openremote/or-dartboard/README.md

# OpenRemote Dartboard

As a proof of concept for connecting a custom-made IoT device to OpenRemote, we developed hardware & software to connect a modified electronic dartboard to OpenRemote, which can then be used to play remote dart games using OpenRemote as an intermediate datastore.

## Documentation

- [Hardware documentation](./docs/hardware.md)
- [Software documentation](./docs/software.md)

## Code

- [ESP32 Code](./esp32)
- [Game logic](./gamelogic)
- [OpenRemote patched w/ custom BLE Support](https://github.com/Raqbit/openremote)
