openremote/or-dartboard/docs/esp32.md

# ESP32 Code

## Diagrams

>**Note**
>
> The diagrams shown here, are made using the [C4 model](https://c4model.com/).
> 
> Also, the code diagrams will not be shown. We will provide you directly with the code.

### (C1) Context Diagram
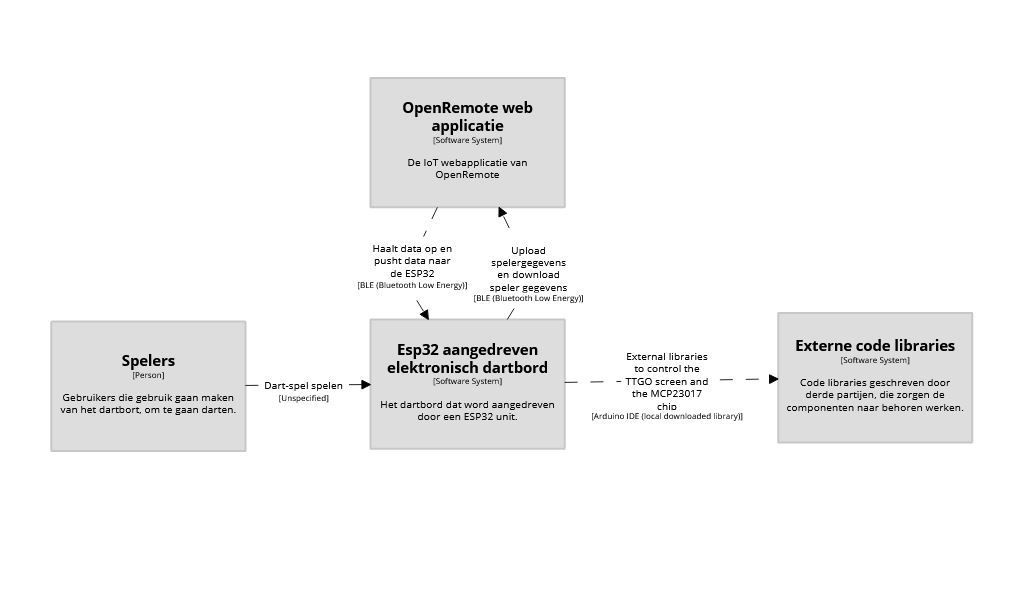
[picture p3: docs/img/esp32/c4/context.jpg]
Context diagram for the ESP32 driven dartboard

>**Note**
>
>These diagrams are written in Dutch. I will do my best to translate them to English correctly.

#### Context overview
In the middle we see our "ESP32 drive electronical dartboard". To the left of the "ESP32 drive electronical dartboard" we see "Players". To the right, wee see "External code libraries." To the top, we see "OpenRemote web application".

* Players interact with the dartboard, throwing darts. No technologies are used for this.
* The ESP32 driven dartboard, will use external code libraries, to make use of the TTGO-T-Display(mounted on the ESP32), the MCP23017 I/O Extender and the Bluetooth Antenne (mounted on the ESP32).
* The Esp32 driven dartboard will also send hit-scan data of darts thrown to OpenRemote. (Using Bluetooth Low Energy)
* OpenRemote will also send data to the ESP32 driven dartboard when needed. (Using Bluetooth Low Energy)

### (C2) Container Diagram Esp32 Driven Dartboard
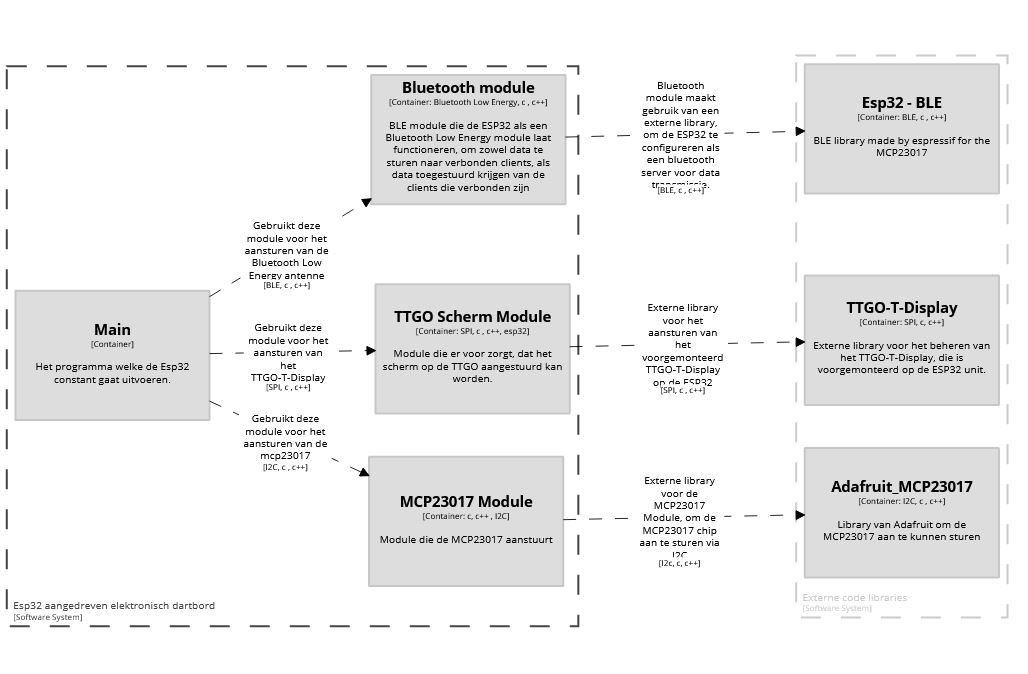
[picture p4: docs/img/esp32/c4/container-esp32.jpg]
Container diagram for the ESP32 Driven Dartboard

>**Note**
>
>The boxes in the diagram **that contain other boxes**, can each be seen as a repository.

#### Container Overview Esp32 Driven Dartboard
This diagram shows the components that the Container: "Esp32 Driven Dartboard" consists of. We see that it's main component relies on 3 other components (which I called modules in the diagram). These 3 components, each further rely on a external component, obtained from an external library.

### (C3) Component Diagram Main
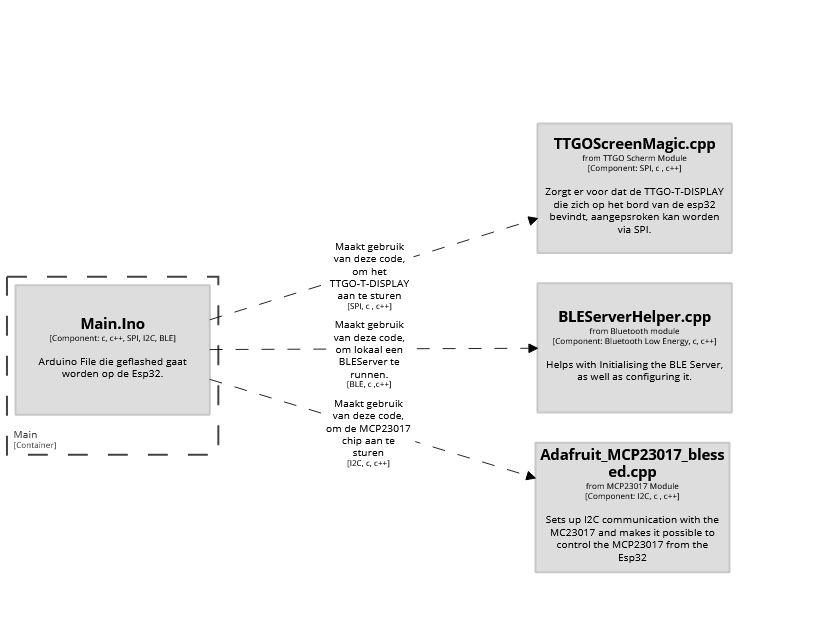
[picture p5: docs/img/esp32/c4/component-esp32.jpg]
Component Diagram for the Main file of ESP32


#### Component Overview Main
This diagram shows, what the "Main.ino" component needs from the other 3 components. This is:
* Using the "TTGOScreenMagic.cpp" component to utilize the TTGO-T-Display, from the ESP32, through SPI.
* Using the "BLEServerHelper.cpp" component to utilize the Bluetooth Low Energy Antenna, mounted on the ESP32.
* Using the "Adafruit_MCP23017_blessed.cpp" component to utilize the MCP23017 through I2C.

### (C3) Component Diagram MCP23017
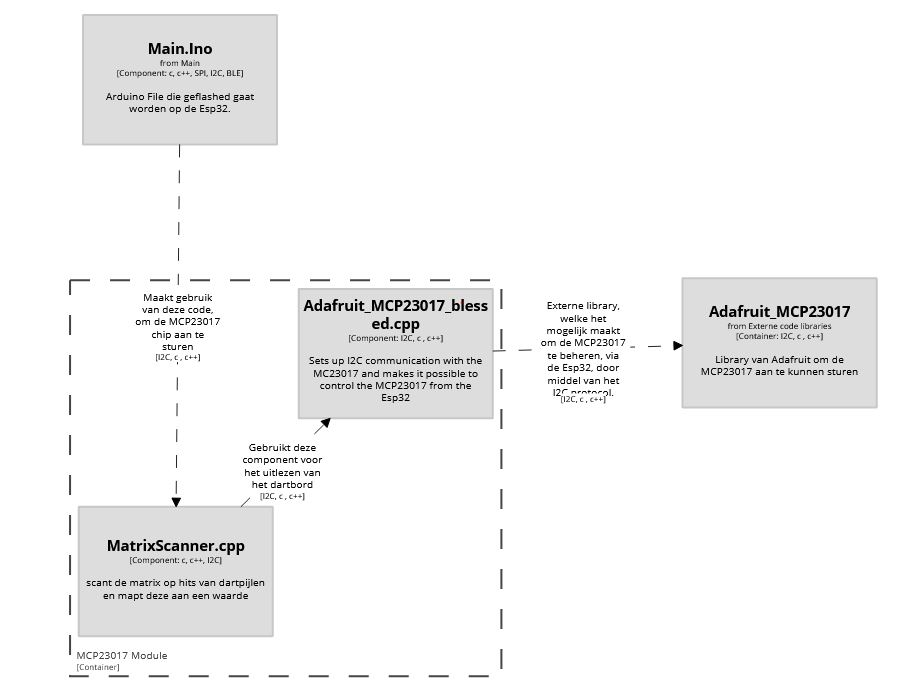
[picture p6: docs/img/esp32/c4/component-matrix-module.jpg]
Component Diagram for the MCP23017 module


#### Component Overview MCP23017
Here we see the Main.ino component, reaching into the MCP23017 container, to use the MatrixScanner.cpp for controlling the MCP23017 and reading the output from the 8x8 button matrix. The component **Adafruit_MCP23017_blessed.cpp** uses a [external library written by Adafruit](https://github.com/adafruit/Adafruit-MCP23017-Arduino-Library)
 
### (C3) TTGO-Screen-Module
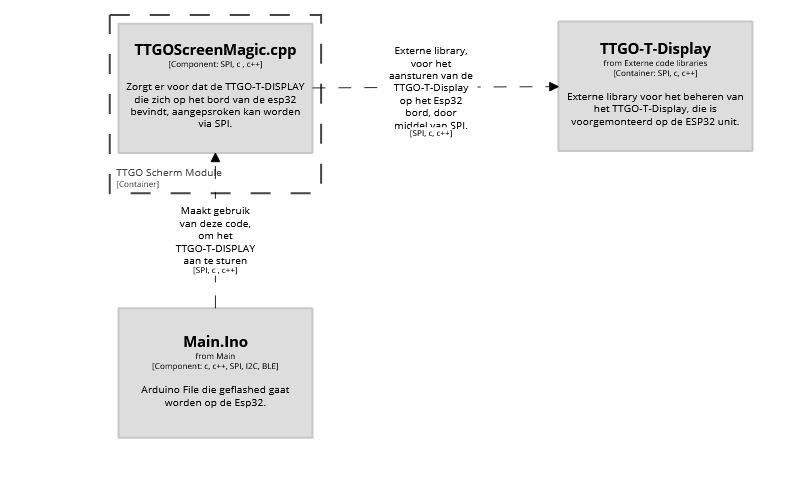
[picture p7: docs/img/esp32/c4/component-screen-module.jpg]
Component Diagram for the TTGO-Screen-Module


#### Component Overview TTGO-Screen-Module
**TTGOSCreenMagic.cpp** uses the external [TTGO-T-Display library](https://github.com/Xinyuan-LilyGO/TTGO-T-Display) to use the TTGO-T-Display, mounted on the ESP32 through SPI.

### (C3) Component Diagram Bluetooth Module
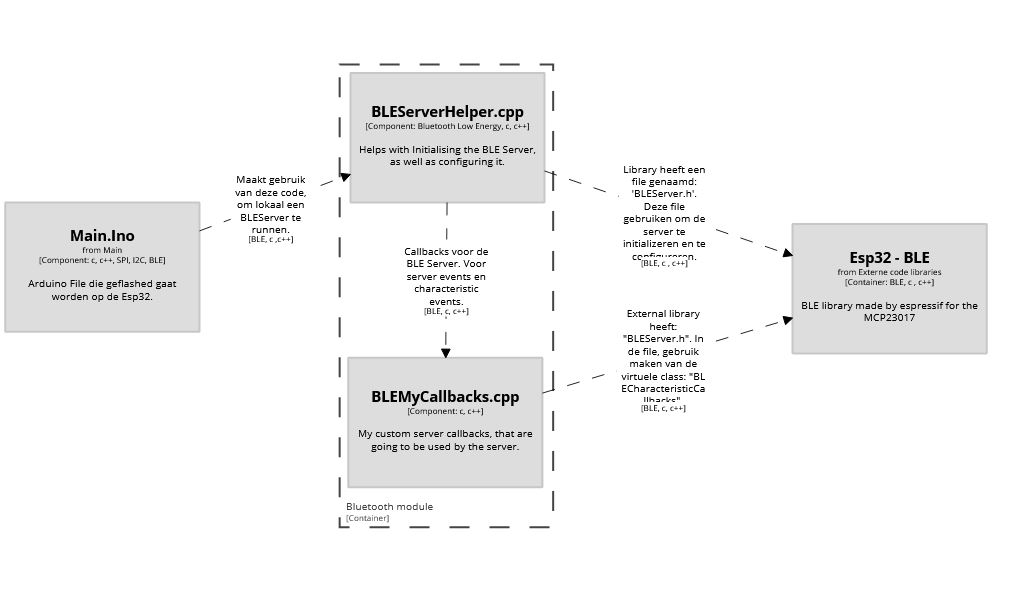
[picture p8: docs/img/esp32/c4/component-bluetooth-module.jpg]
Component Diagram for the Bluetooth module


#### Component Overview Bluetooth Module
Both **BLEServerHelper.cpp** and **BLEMyCallbacks.cpp** use the [external code library from espressif](https://github.com/espressif/arduino-esp32/tree/master/libraries/BLE/src) to control the BLE antenna, that is mounted on the ESP32. **Main** only uses **BLEServerHelper.cpp**
