openremote/or-dartboard/(commit log)

2021-01-20 Moved things around + Finished esp32.md
2021-01-20 Updated esp32.md, external links, Tekst-markup
2021-01-20 Updated esp32.md again
2021-01-20 Yet again an esp32.md update..
